aabadie/aabadie-pcb/README.md

aabadie-pcb board design and support
====================================

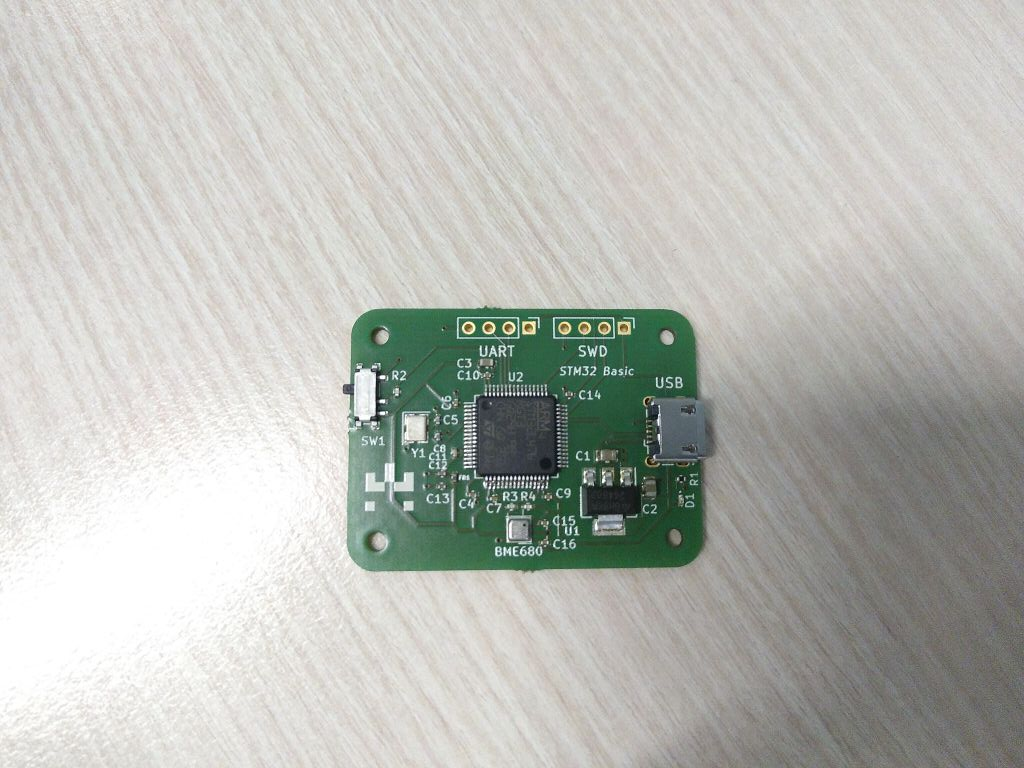
[picture p1: assets/aabadie-pcb.jpeg]
pcb


This repository contains both the Kicad project used to design aabadie-pcb board and also a RIOT port to this board.
