aabadie/aabadie-pcb/schematics/629105150521 (rev1).stp

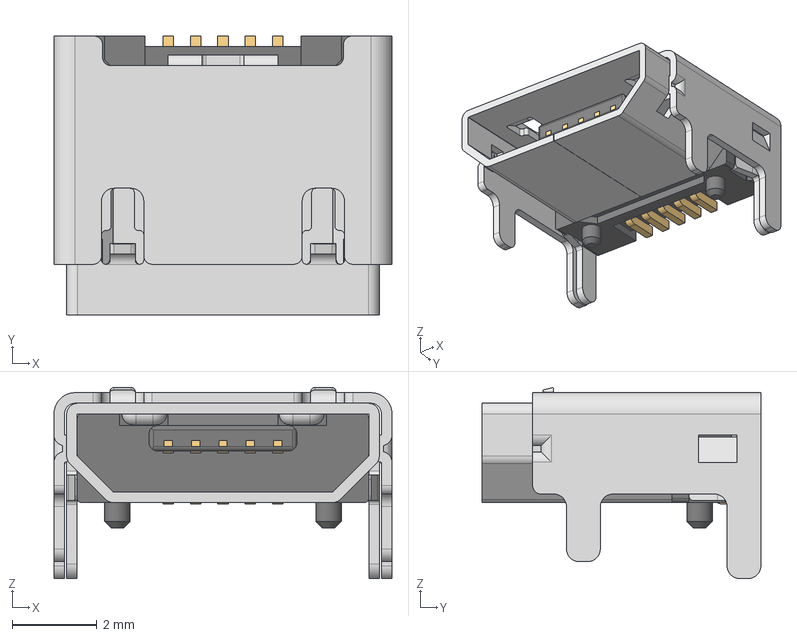
[picture p2: CAD file, 2023-03-06]
schematics/629105150521 (rev1).stp
8.00 x 6.60 x 4.52 mm
629105150521_Housing
629105150521_Pin1 x 4
629105150521_Pin2
629105150521_Shielding2
629105150521_Shielding
