aabadie/aabadie-pcb/schematics/aabadie-pcb.kicad_pcb

## KiCad design schematics/aabadie-pcb.kicad_pcb (2023-03-06)

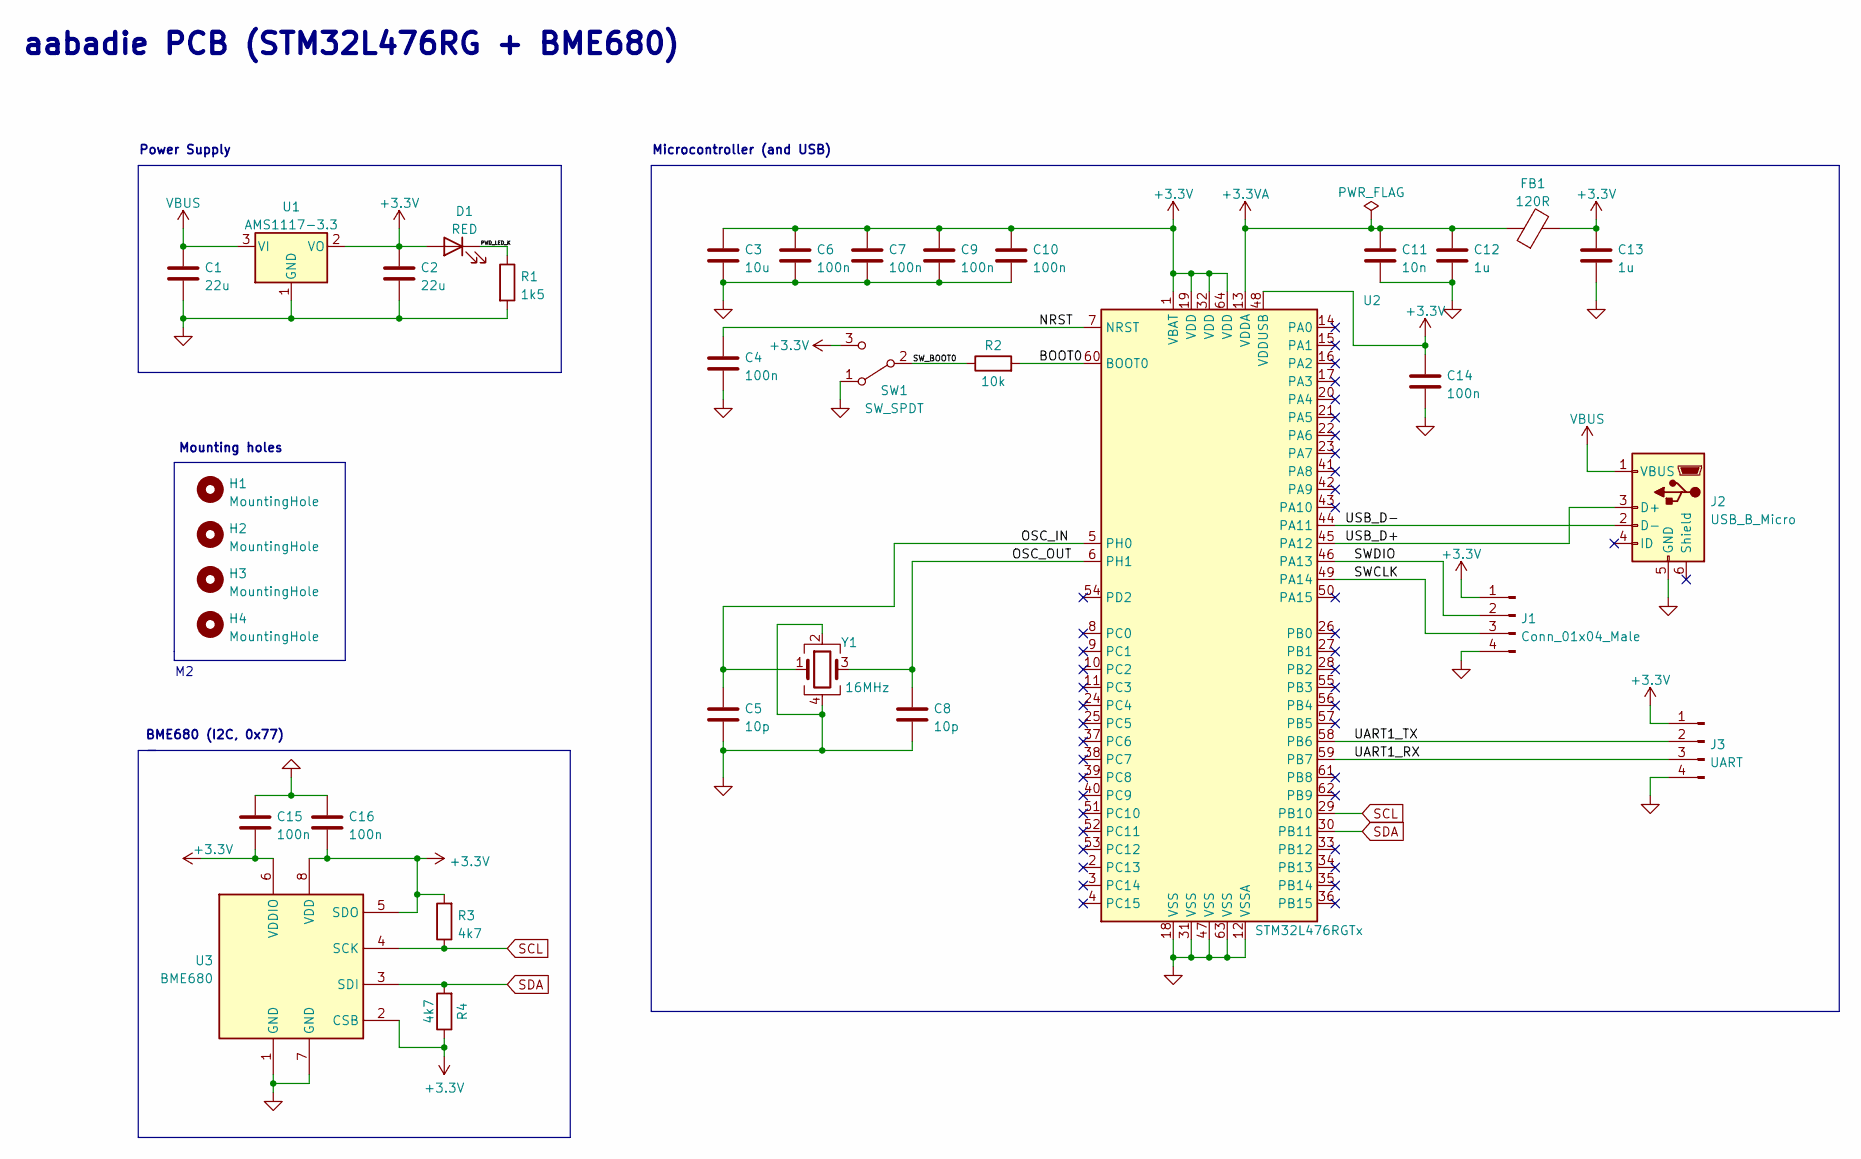
[picture p3: schematic aabadie-pcb.kicad_sch, aabadie PCB]

Parts:
C1, C2: 22u; C_0805_2012Metric
C3: 10u; C_0603_1608Metric
C4, C6, C7, C9, C10, C14, C15, C16: 100n; C_0402_1005Metric
C5, C8: 10p; C_0402_1005Metric
C11: 10n; C_0402_1005Metric
C12, C13: 1u; C_0402_1005Metric
D1: RED; LED_0402_1005Metric
FB1: 120R; L_0402_1005Metric
H1, H2, H3, H4: MountingHole; MountingHole_2.2mm_M2
J1: Conn_01x04_Male; PinHeader_1x04_P2.54mm_Vertical
J2: USB_B_Micro; USB_Micro-B_Wuerth_629105150521
J3: UART; PinHeader_1x04_P2.54mm_Vertical
R1: 1k5; R_0402_1005Metric
R2: 10k; R_0402_1005Metric
R3, R4: 4k7; R_0402_1005Metric
SW1: SW_SPDT; SW_SPDT_PCM12
U1: AMS1117-3.3; SOT-223-3_TabPin2
U2: STM32L476RGTx; LQFP-64_10x10mm_P0.5mm
U3: BME680; Bosch_LGA-8_3x3mm_P0.8mm_ClockwisePinNumbering
Y1: 16MHz; Crystal_SMD_3225-4Pin_3.2x2.5mm

Connections:
+3.3V: C2.2, C3.1, C6.1, C7.1, C9.1, C10.1, C13.1, C14.1, C15.2, C16.2, D1.2 (A), FB1.2, J1.1, J3.1, R3.2, R4.1, SW1.3 (C), U1.2 (VO), U2.1 (VBAT), U2.19 (VDD), U2.32 (VDD), U2.48 (VDDUSB), U2.64 (VDD), U3.2 (CSB), U3.5 (SDO), U3.6 (VDDIO), U3.8 (VDD)
+3.3VA: C11.1, C12.1, FB1.1, U2.13 (VDDA)
/BOOT0: R2.2, U2.60 (BOOT0)
/NRST: C4.1, U2.7 (NRST)
/OSC_IN: C5.1, U2.5 (PH0), Y1.1
/OSC_OUT: C8.1, U2.6 (PH1), Y1.3
/PWD_LED_K: D1.1 (K), R1.1
/SWCLK: J1.3, U2.49 (PA14)
/SWDIO: J1.2, U2.46 (PA13)
/SW_BOOT0: R2.1, SW1.2 (B)
/UART1_RX: J3.3, U2.59 (PB7)
/UART1_TX: J3.2, U2.58 (PB6)
/USB_D+: J2.3 (D+), U2.45 (PA12)
/USB_D-: J2.2 (D-), U2.44 (PA11)
GND: C1.2, C2.1, C3.2, C4.2, C5.2, C6.2, C7.2, C8.2, C9.2, C10.2, C11.2, C12.2, C13.2, C14.2, C15.1, C16.1, J1.4, J2.5 (GND), J3.4, R1.2, SW1.1 (A), U1.1 (GND), U2.12 (VSSA), U2.18 (VSS), U2.31 (VSS), U2.47 (VSS), U2.63 (VSS), U3.1 (GND), U3.7 (GND), Y1.2, Y1.4
SCL: R3.1, U2.29 (PB10), U3.4 (SCK)
SDA: R4.2, U2.30 (PB11), U3.3 (SDI)
VBUS: C1.1, J2.1 (VBUS), U1.3 (VI)

Notes on the sheet:
aabadie PCB (STM32L476RG + BME680)
Power Supply
BME680 (I2C, 0x77)
Mounting holes
Microcontroller (and USB)

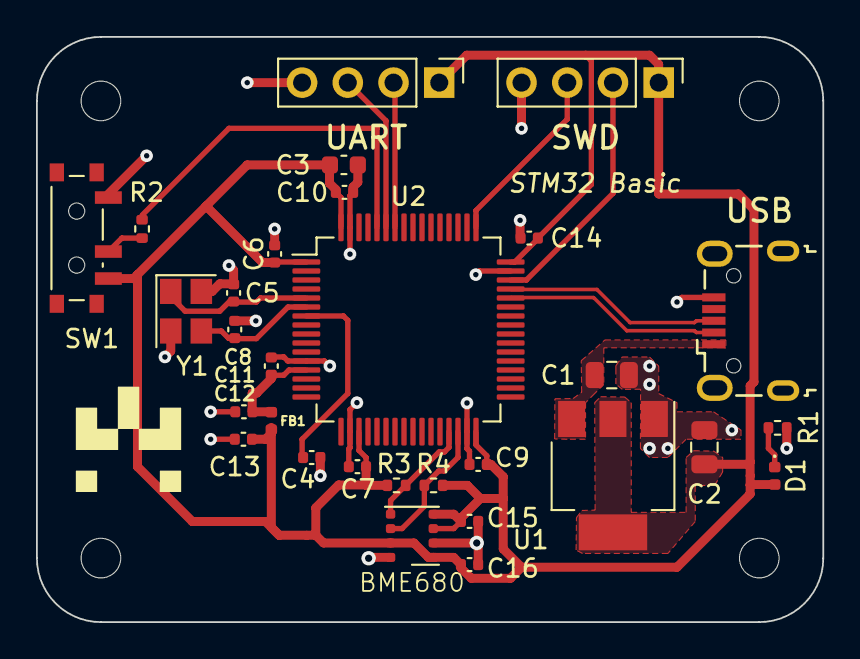
[picture p4: board aabadie-pcb.kicad_pcb from above]

Board: 2 copper layers, 43.7 x 32.5 mm, 34 parts (0 on the bottom side), 18 nets.
