aabadie/aabadie-pcb/(commit log)

2023-03-06 schematics: add initial version of Kicad project
    [629105150521 (rev1).stp, aabadie-pcb.kicad_pcb, aabadie-pcb.kicad_sch]
2023-03-06 README.md: add README with basic notes and a picture of the board
2023-03-06 assets: rotate board picture
2023-03-07 README.md: fix typo in board name and adjust setup notes
